cobetckoe/LightStander/README.md

# LightStander 站光侠

> **股票也许会欺骗你，但是站光侠永远不会。**

> **赌王不赌，股神不炒，让太阳做你的操盘手。**

> **市场没有你能掌握的规律，太阳却有亘[gèn]古不变的光。**



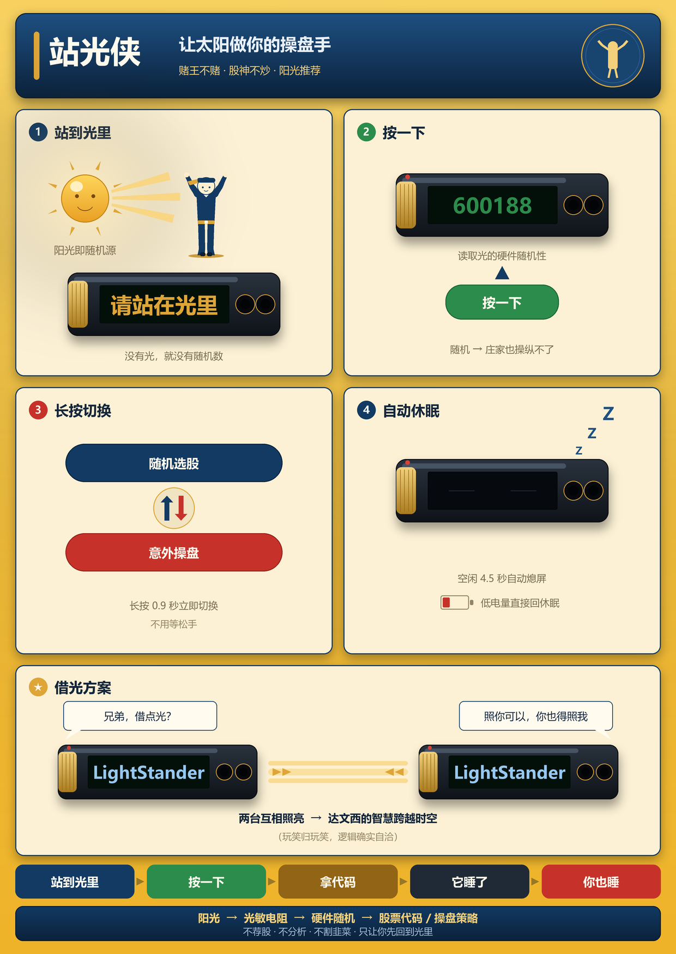
[picture p1: docs/images/how-it-works.png]
一页看懂站光侠


## 它是什么

LightStander，**站光侠** — 一款外观 1:1 仿照光模块工业设计的掌上随机决策器。

它不是股票推荐器，也不是操盘软件；它只是把“决定权”交给真实环境光。站在阳光下按下一次按钮，设备会读取光照的硬件随机性，并给出一支股票代码或一次操盘动作。它不荐股、不分析、不割韭菜，只让你在盯盘之前先回到光里。

## 快速上手

1. **充满电**（USB-C，一次约半年）
2. **站到阳光下**，按一下中间按钮
3. **看屏幕**：一支股票代码，或一次操盘策略
4. 太暗会提示「请站在光里」— 你也可以用另一台的手电筒照它（见[借光方案](#借光方案)）

就这么简单。它会自己睡觉，你只要偶尔带它晒晒太阳。

| 想知道 | 看这里 |
|---|---|
| 按键怎么用、屏幕显示什么 | [操作说明](#操作说明) |
| 里面都是些什么零件 | [硬件配置](#硬件配置) |
| 便宜 MCU 怎么塞下整个股市 | [设计哲学](#设计哲学) |
| 为什么叫站光侠、什么是光功德 | [设计理念](#设计理念) |
| 怎么编译、源码结构 | [开发环境](#开发环境) |

## 发版信息

当前版本：**v1.0.0**（首发第一版）

- 硬件目标：STC8G1K08A（8KB Flash）
- 编译验证：已通过 Keil 构建
- 实测大小：7714 / 8192 bytes，余量 478 bytes
- 功能状态：随机选股、随机操盘、低光提示、低压保护、低功耗待机均保留

## 功能介绍

- **随机选股**：覆盖沪深两市 + 北交所共 **5914** 支 A 股，按真实上市数量加权随机
- **随机操盘**：补仓、空仓、平仓、减仓、半仓、建仓、加仓、持仓、满仓 9 种操盘策略
- **光照感知**：环境光不足时提示「请站在光里」，走到阳光下才能选（低光不计光功德）
- **感光标定**：100K 分压 + 光敏电阻上臂，只有接近饱和的直射阳光才放行
- **手电筒**：侧边点动开关，按下点亮、松手熄灭（不保持）
- **光功德**：记录你在阳光下积累的清醒次数（断电不丢失）
- **低压保护**：电池电压低于阈值时不执行选股，直接回休眠，避免过放电
- **超低功耗**：待机仅约 5μA，空闲 4.5 秒自动熄屏回 STOP

## 硬件配置

| 组件 | 型号 / 规格 |
|---|---|
| MCU | STC8G1K08A（8KB Flash, 256B iRAM, 1K xRAM, 24MHz） |
| 显示 | SSD1306 OLED 128×32，软件 I2C（SCL=P5.5, SDA=P5.4） |
| 操作按钮 | P3.2 / INT0，睡眠时低电平唤醒，运行中下降沿触发 |
| 侧边开关 | 点动按钮（按下点亮、松手熄灭），独立于 MCU，可发送摩尔斯电码 |
| 光传感器 | P3.3 ADC3，光敏电阻接上臂、100K 接 GND，光越强读数越大 |
| 充电 | TP4057 锂电池充电管理，USB-C 输入 |
| 电池 | 3.7V 锂聚合物电池 100mAh，Type-C 充电 |

详细硬件设计请参阅 [docs/HARDWARE.md](docs/HARDWARE.md)。

## 操作说明

设备通电后自动进入待机题目页，无需任何操作。**空闲 4.5 秒自动熄屏并回到 STOP 休眠**，下次按键重新唤醒。

1. **按一次中间按钮**：唤醒设备，待机题目页亮起
   - 光照充足 → 随机显示一个股票代码或操盘策略，光功德 +1
   - 光照不足 → 显示「请站在光里」，请移动到更亮的位置
2. **按住中间按钮不放**：约 0.9 秒后**立即**切换模式并刷新屏幕，无需等松手（随机选股 ⇄ 意外操盘）
3. **侧边点动按钮**：按下点亮手电筒、松手熄灭（不保持）。可用来发送摩尔斯电码——短按为点（·），长按为划（-）

### 屏幕显示

一次完整操作依次经过三个页面：

1. **题目页（待机）**：居中显示当前模式 `随机选股` / `意外操盘`。
2. **结果页**：第一行保持题目，第二行显示本次结果。
   - `6 位数字`：随机股票代码。
   - `2 字`：随机操盘策略（补仓/空仓/平仓/减仓/半仓/建仓/加仓/持仓/满仓）。
3. **功德页**：第一行 `光功德+1`（本次已记录），第二行显示累计总功德。

其他提示：
- 整屏 `请站在光里`：光线不足，请移到阳光下。此时按一下键可立即返回待机；低光提示**不计**光功德
- 整屏 `电池图标`：电量不足，设备立即熄屏回休眠，请充电

光照判据直接看 ADC 原始读数，**达到 1015 以上**才放行（10 位 ADC，满量程 1023）。实测完全遮住 867、室内阴天约 950、直射阳光 1023，所以只有真的举到太阳底下才过得去。阈值是 `Sources/adc.c` 里的 `LIGHT_SUN_ADC`，想放宽或收紧只改这一个数。

电路接法与标定过程见 [docs/HARDWARE.md](docs/HARDWARE.md)。

页面停留时间：结果页约 1.8 秒，功德页约 1.0 秒，之后自动回到待机题目页。

### 电池说明

- **充电**：USB-C 接口充电，内置 TP4057 充电管理芯片。
- **低电量保护**：设备在每次唤醒和每次按键时自动检测电池电压。当电压低于阈值时，屏幕显示电池耗尽图标约 1.2 秒，然后设备直接熄屏回休眠（**不执行选股**），以保护电池不过度放电。
- **电池寿命**：100mAh 锂电池充满后可持续数十次操作，日常使用约半年充一次。
- **长期存放**：超过 3 个月不使用，建议充满电后存放。锂电池长期亏电可能永久损坏。
- **工作温度**：锂电池建议在 0°C~45°C 范围内使用，过低或过高温度均会影响性能。
- **断电不丢失**：设备会保存光功德与当前模式。

### 借光方案

如果环境光线不足，设备会提示「请站在光里」。走到阳光下是最正统的方案。但如果你正在地下室、深夜、或者阴天，还有一个**达文西式的解决方案**：

打开另一台站光侠的侧边手电筒照射光敏电阻，等于用同类设备互相点亮。

是的，这听起来很荒谬 —— 用一台站光侠去照亮另一台站光侠。但仔细想想，它的逻辑是自洽的：**站光侠的光传感器需要光，另一台站光侠的手电筒有光，问题解决。**

> 这不是 bug，这是 feature。达文西的智慧，跨越时空，在一个掌上设备上得到了验证。

## 设计哲学

> 一粒米养百样人，一KB 包万象物。

本项目的核心工程挑战是：**在 8KB Flash、256 字节 RAM 的极限空间内，塞进一个完整的股票随机系统。**

| 资源 | 总量 | 已用 | 利用率 |
|---|---|---|---|
| Flash (Code) | 8192 B | 7714 B | **94.2%** |
| iRAM | 256 B | 9 B | 3.5% |
| xRAM | 1024 B | 49 B | 4.8% |
| 引脚 | 8 (SOP-8) | 6 个，剩 P3.0/P3.1 悬空 | 75% |

这是一颗只有 **8KB Flash、8 个引脚、售价不到 1 元**的 MCU。我们把它榨得很干净：

- **位图压缩**：5914 支股票用位图表示，1 bit = 1 支股票，12 组前缀压缩进 1.5KB
- **字模复用**：27 个 16×16 中文字模精打细算，每一个字位都被利用
- **软件 I2C**：没有硬件 I2C？用 GPIO 软件模拟，两根线搞定 OLED
- **带隙基准**：用芯片内置的 1.19V 基准反推电池电压，省掉外部参考电压
- **STOP 模式**：待机 5μA，唤醒 10ms，一颗锂电池撑半年
- **双备份 EEPROM**：断电不丢数据，两个槽位交替写入

P3.0 和 P3.1 是 UART 兼 ISP 下载口，固件不碰它们，保持上电默认的弱上拉——既不影响下载，也能压住悬空干扰。

**六个引脚全在干活，一个字节都没白占。**

## 设计理念

### 名字由来

**「你要站在光里，不要光站在那里。」** —— 这是 2026 年股市流传最广的一句话。别人说这句话是在激励你行动，而站光侠说这句话，是让你**物理上真的站到光里**。

别人大喊「站在光里」的时候，心里想的是信心、勇气、不要犹豫。而你低头看了一眼手里的光模块，走到阳光下，按了一下按钮。你们都在「站在光里」，但你是唯一一个字面意义上做到了的。

当你站在阳光下，光线通过光敏电阻产生真实世界的物理熵 — 每一颗光子的到达都是量子级别的随机事件。这个随机数不听庄家的，不看K线图，不被任何力量操控。

**它是你在这个充满信息不对称的市场里，能获得的唯一真实的东西。**

### 模块外观

因为讽刺，也因为科普。

光模块今年被炒上了天，概念股翻了几倍，无数人疯狂买入。但你问他们光模块长什么样、里面的芯片怎么工作、一个 SFP28 封装里塞了哪些光器件 — 他们答不上来。**很多人甚至没有见过光模块长什么样子，就敢把身家压上去。**

所以站光侠的另一个意义，就是让你**真正认识光模块**。拿在手里，你就知道光模块不是什么神秘的印钞机，它就长这个样子 — 一个普普通通的光学器件。1:1 仿照光模块的工业设计，让你看看你追的股票背后的实物到底是个什么玩意。

拿在手里，别人以为你在搞什么高科技，其实你在晒太阳。

**让光模块的光，真正照进你的生活 — 而不是照进庄家的口袋。**

### 侠客哲学

> 你苦心纠结选的股票，也许不如太阳推荐的靠谱。
> 你研究很久的操盘方法，也许不如让太阳做你的操盘手。

K线会骗你，均线会骗你，量价关系会骗你，但太阳不会。它不关心你的持仓，不在乎你的成本，不理会你的焦虑。它只是公平地照在每一个人身上。

**赌王不赌，股神不炒。** 真正的高手，从不在赌桌上和概率较劲。他们知道，唯一确定的事就是不确定性本身。而站光侠，把这种确定的不确定性，装进了你的掌心。

### 光之功德

每一次在阳光下按下按钮，光功德 +1。这不只是计数，这是一种仪式感：

- 站到阳光里 = 停止盯盘，去晒太阳
- 按下按钮 = 接受随机的命运
- 光功德 +1 = 你今天比 99% 的散户更清醒

> 光功德者，日光所积也。每一步走向阳光，都是一次与韭菜命运的决裂。

## 公开声明

站光侠的核心是一个**真正基于物理熵的随机数发生器**。光子的到达时间是量子级别的随机事件，这使得它产生的随机数比任何软件算法更具有真实随机性。

该项目面向工程学习、硬件二创、极限 MCU 设计与个人娱乐场景，适合作为教学、实验和创意装置参考。它不是投资建议，也不构成任何金融推荐。

## 开发环境

- **IDE**：Keil μVision 5.38（MDK-51 V9.60）
- **目标芯片**：STC8G1K08A
- **烧录工具**：STC-ISP

## 编译构建

```bash
# 命令行编译
C:\Keil_v5\UV4\UV4.exe -b LightStander.uvproj -r -j

# 或在 Keil 中按 Ctrl+F7（Rebuild）
```

编译产物位于 `Objects/LightStander.hex`。

## 项目结构

```
LightStander/
├── Sources/
│   ├── main.c
│   ├── adc.c / adc.h
│   ├── display.c / .h
│   ├── eeprom.c / .h
│   ├── keys.c / .h
│   ├── modes.c / .h
│   ├── oled.c / .h
│   ├── random.c / .h
│   ├── stop.c / .h
│   ├── bitmap.h
│   ├── font_cn_16.c / .h
│   ├── STC8G_H_ADC.c / .h
│   ├── STC8G_H_EEPROM.c / .h
│   └── inc/
│       ├── config.h
│       ├── def.h
│       └── STC8H.h
├── Tools/
│   ├── fetch_stocks.py
│   ├── gen_font16.py
│   ├── inspect_font.py
│   └── verify_ink.py
├── docs/
│   ├── HARDWARE.md
│   ├── ARCHITECTURE.md
│   └── images/
├── release/
│   └── v1.0.0/
├── LightStander.uvproj
├── .gitignore
├── .gitattributes
├── LICENSE
├── CHANGELOG.md
└── CONTRIBUTING.md
```

## 工具脚本

### 股票数据

```bash
# 从巨潮资讯 + 新浪财经抓取最新 A 股列表
python Tools/fetch_stocks.py
```

### 中文字模

```bash
# 需要 PIL（Pillow）和 simsun.ttc 字体
python Tools/gen_font16.py
```

### 墨宽工具

中文字模的 16×16 单元格只是外框，实际墨迹宽度为 13~15px，因此 layout 坐标按**实测墨宽**排布，而非固定单元格间距。

```bash
# 测量每个字模的真实墨宽与起止列（坐标定位的依据）
python Tools/inspect_font.py

# 校验字模墨宽与 display.c 中的坐标假设一致
python Tools/verify_ink.py
```

## 开源协议

[GNU General Public License v3.0](LICENSE)

遵守 GPL-3.0：修改后分发项目时，必须同样以 GPL-3.0 开源，并保留原作者版权声明。

## 致谢

- 代码部分完全由mimo模型生成，人还是要有梦想的，万一AI帮你实现了呢
- 嘉立创社区：提供 PCB 白嫖打样服务，股票代码：001232
- STC 微控制器 — 用不到 1 元的价格，给了我们 8KB 的无限可能，装下了整个股市的荒诞
- 操盘字段来源MakeWorld项目：上上签签子-炒股，有助力的请助力
- 全 A 股数据来源：巨潮资讯、新浪财经 — 感谢你们提供 5914 个让人心跳加速的数字
- 所有在阳光下按下按钮的站光侠 — 你们是这个时代最清醒的投资者

> **股票也许会欺骗你，但是站光侠永远不会。**
