cobetckoe/LightStander/CHANGELOG.md

# Changelog

## [1.0.0] - 2026-11-02

### 发布

- LightStander 站光侠首个正式版本
- 已通过 Keil 构建验证，0 错误 0 警告
- 固件 7714 / 8192 字节（余量 478 字节，94.2%）

### 功能

- 随机选股：12 组前缀权重分布，共 5914 支候选
- 随机操盘：9 种仓位动作
- 光功德：阳光下每次操作累计 +1，掉电不丢
- 低光保护：光照不足时显示「请站在光里」并返回待机
- 低压保护：VDD 低于约 2.9V 时显示电池图标后关机
- 低功耗：STOP 待机，按键唤醒
- 片上 EEPROM 双槽备份存储
- SSD1306 128×32 OLED 显示

### 设计

- **光判据直接比较 ADC 原始值**。10 位 ADC 满量程 1023，强光下分压
  饱和即放行（阈值 1015）。饱和点与电池电压无关，天然免疫电压漂移，
  也不依赖带隙补偿。
- **EEPROM 用 7 字节记录**：`chk | merit[4] | mode | seq`，校验字节最先
  写入，任何半写立刻被拒；双槽交替写入，另一槽永远是上一笔完整记录。
- **OLED 命令收敛为一张表** `oled_cfg[][2]`，冷启动与唤醒共用。开屏时机
  统一交给调用方，保证「先画完再点亮」，屏幕从黑直接过渡到第一帧。
- **冷启动先拉低总线泄放 250ms**，逼面板跌破 POR 门限真正复位。烧录、
  看门狗复位这类「面板一直有电」的重启全靠这一步，否则屏幕全黑。
  泄放之后每 5ms 探一次 ACK，面板一应答就继续，最多等 300ms。
- **入睡用低电平触发**，手按着就一直是唤醒条件，不依赖「有没有那一个
  边沿」；醒来立刻切回下降沿，长按不会被当连击。`EX0` 始终使能——它是
  唯一的唤醒源，关掉就只能拔电池。
- **随机数用满周期 LCG**（增量 `0x3B7B` 为奇数），种子取自 ADC 噪声。
- **注释只写「为什么这么做」**，不写推导过程，读代码不用先读论文。

### 说明

- 软件 I2C 需外部上拉电阻（推荐 4.7KΩ 接 3.3V）
- OLED 建议稳压供电，不建议直连电池满电 4.2V
- 光照阈值 1015 对应分压上臂 100K；换板需按实机重新标定
- 本机实测读数：完全遮挡 867、室内阴天约 950、直射阳光 1023
